trandat09062003/Smart_HVAC_AIOT/comparison_chart.png

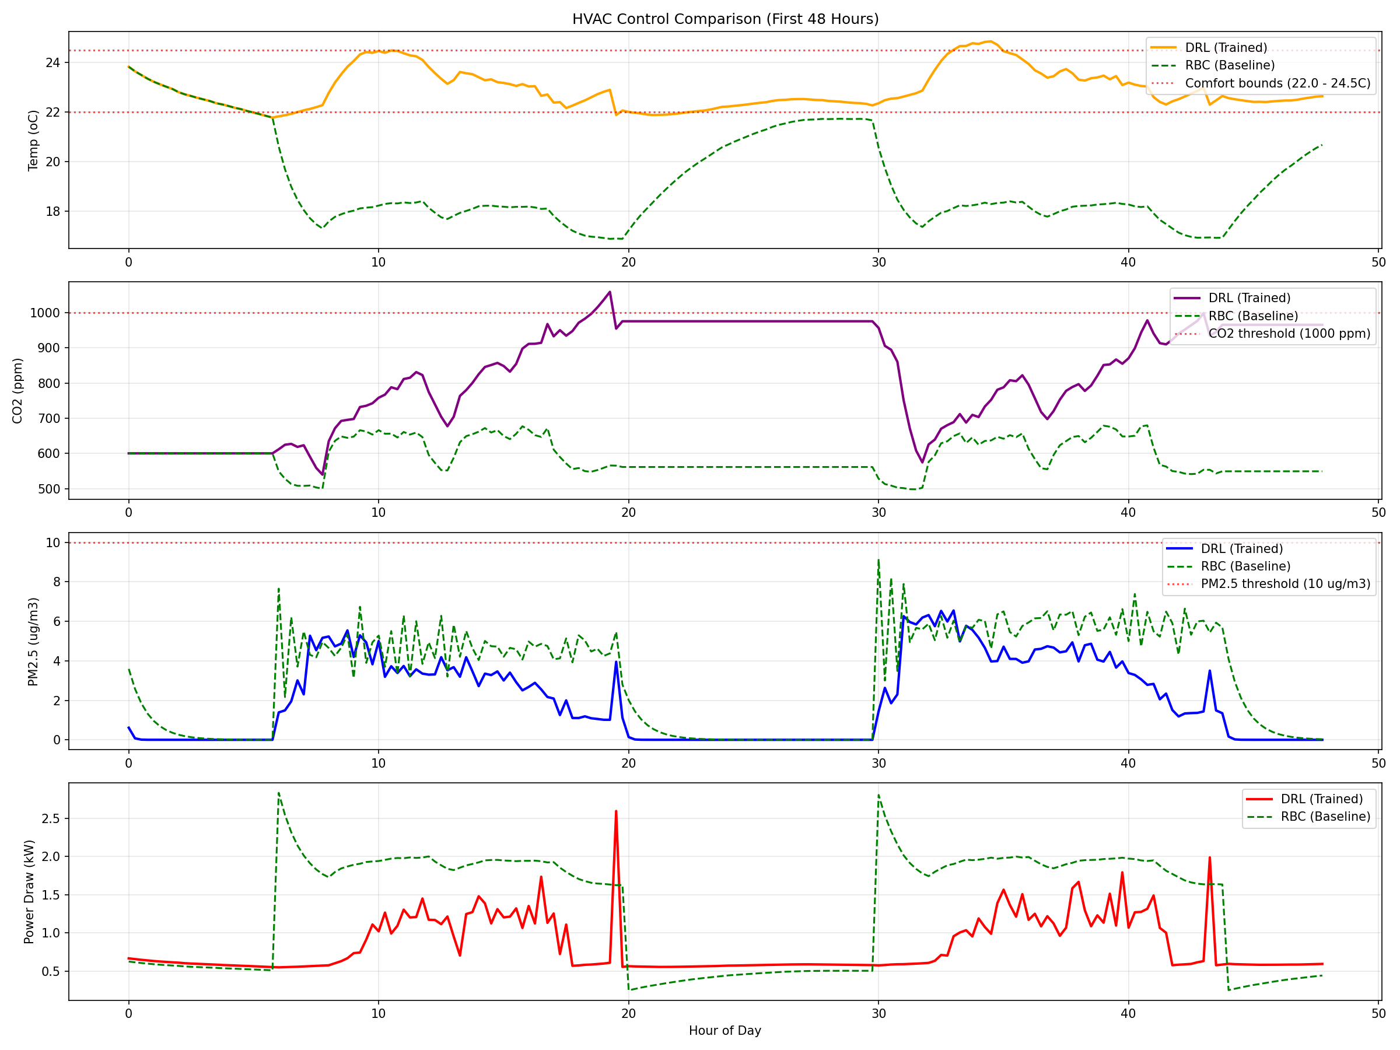
comparison_chart.png
