trandat09062003/Smart_HVAC_AIOT/models/temperature_model/hvac_visual_simulation.gif

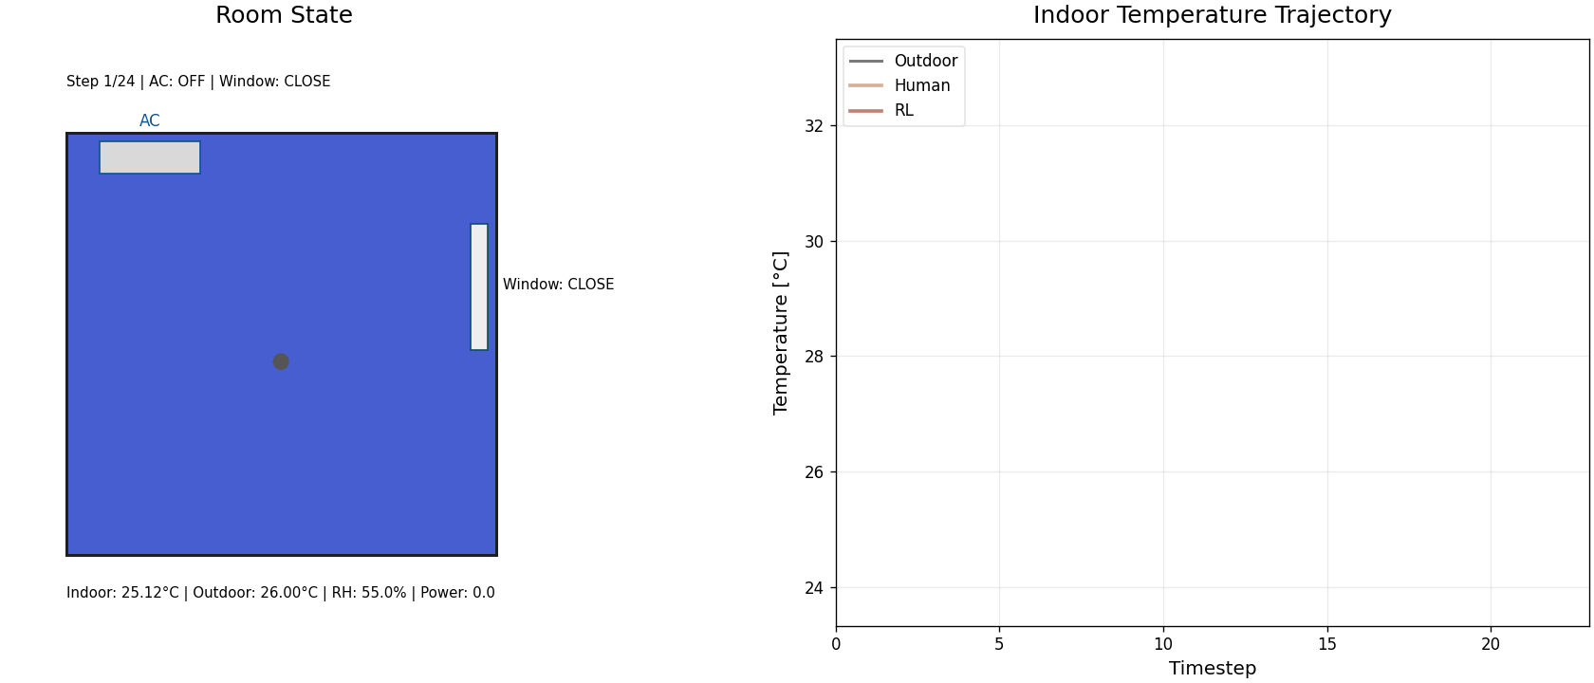
models/temperature_model/hvac_visual_simulation.gif
