trandat09062003/Smart_HVAC_AIOT/models/temperature_model/hvac_visual_simulation_plot.png

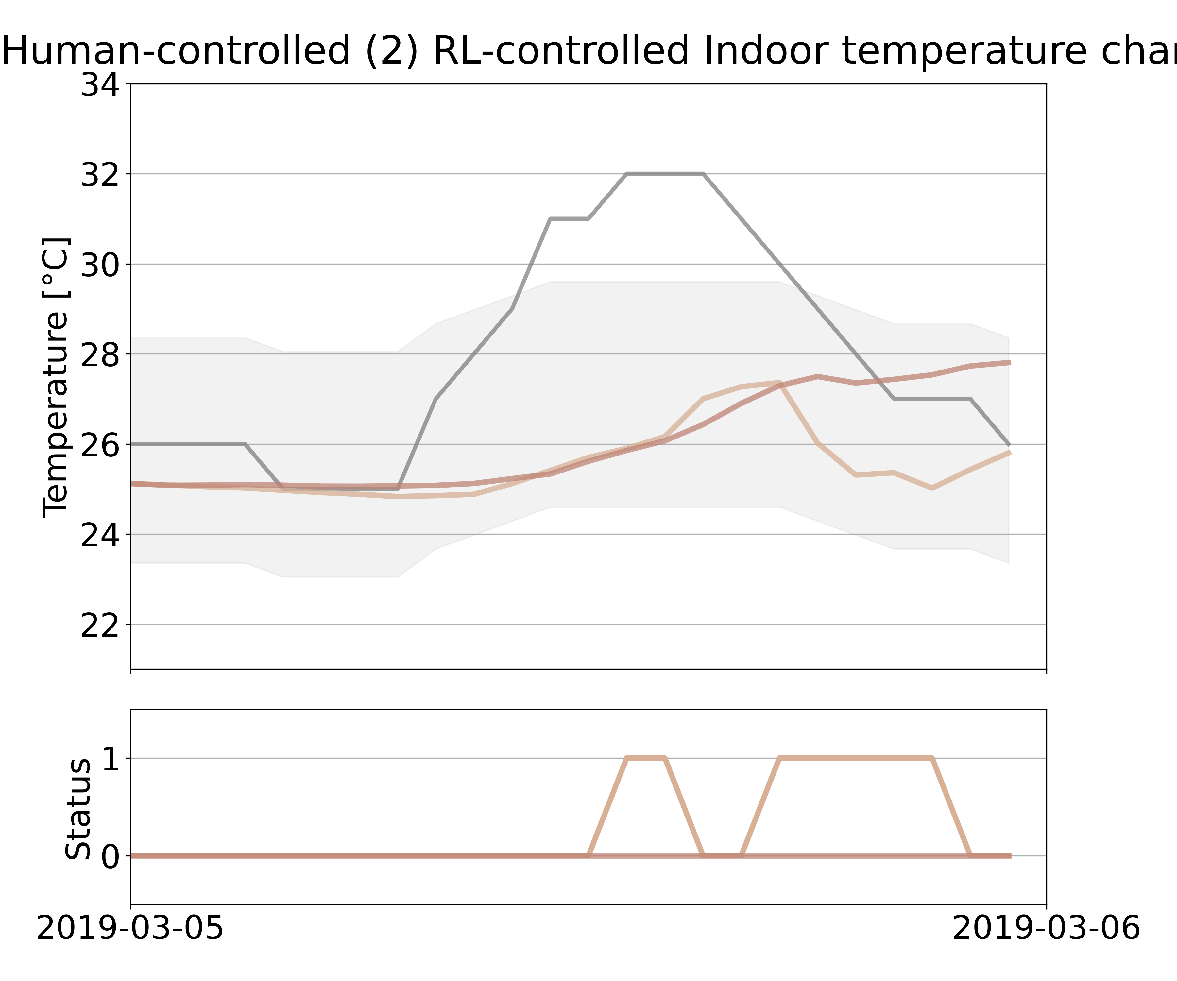
models/temperature_model/hvac_visual_simulation_plot.png
