trandat09062003/Smart_HVAC_AIOT/models/temperature_model/scenario_output_mixed_office_xgbrl.png

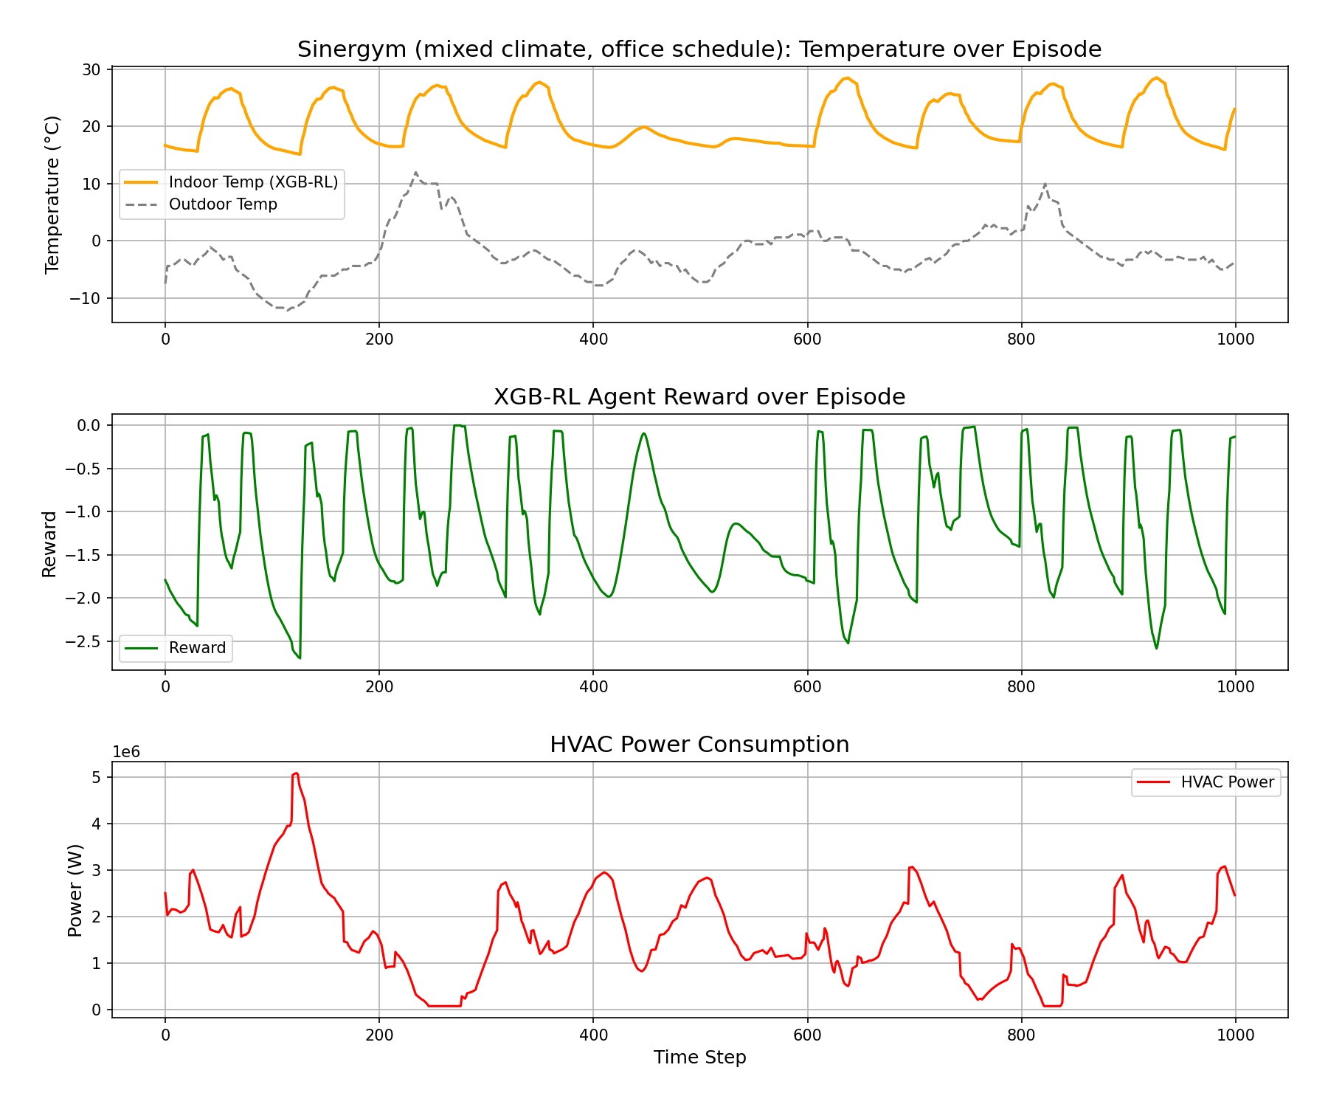
models/temperature_model/scenario_output_mixed_office_xgbrl.png
