trandat09062003/Smart_HVAC_AIOT/models/temperature_model/Eplus-5zone-mixed-continuous-v1-res1/episode-1/output/eplusout.dxf

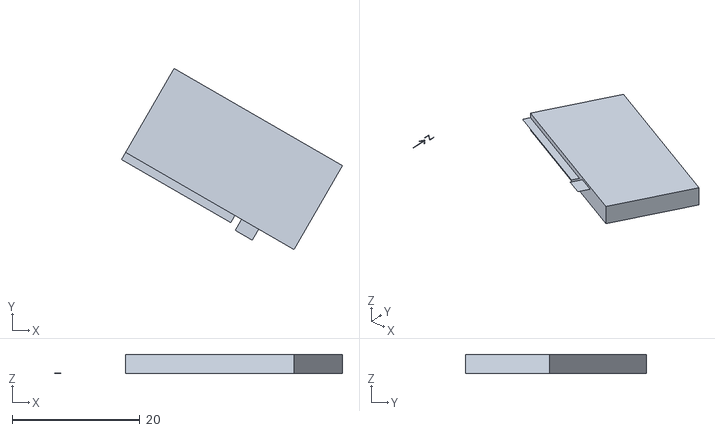
[picture p5: CAD file, 2026-06-03]
models/temperature_model/Eplus-5zone-mixed-continuous-v1-res1/episode-1/output/eplusout.dxf
45.2 x 28.4 x 3.00
