trandat09062003/Smart_HVAC_AIOT/models/temperature_model/performance_comparison.png

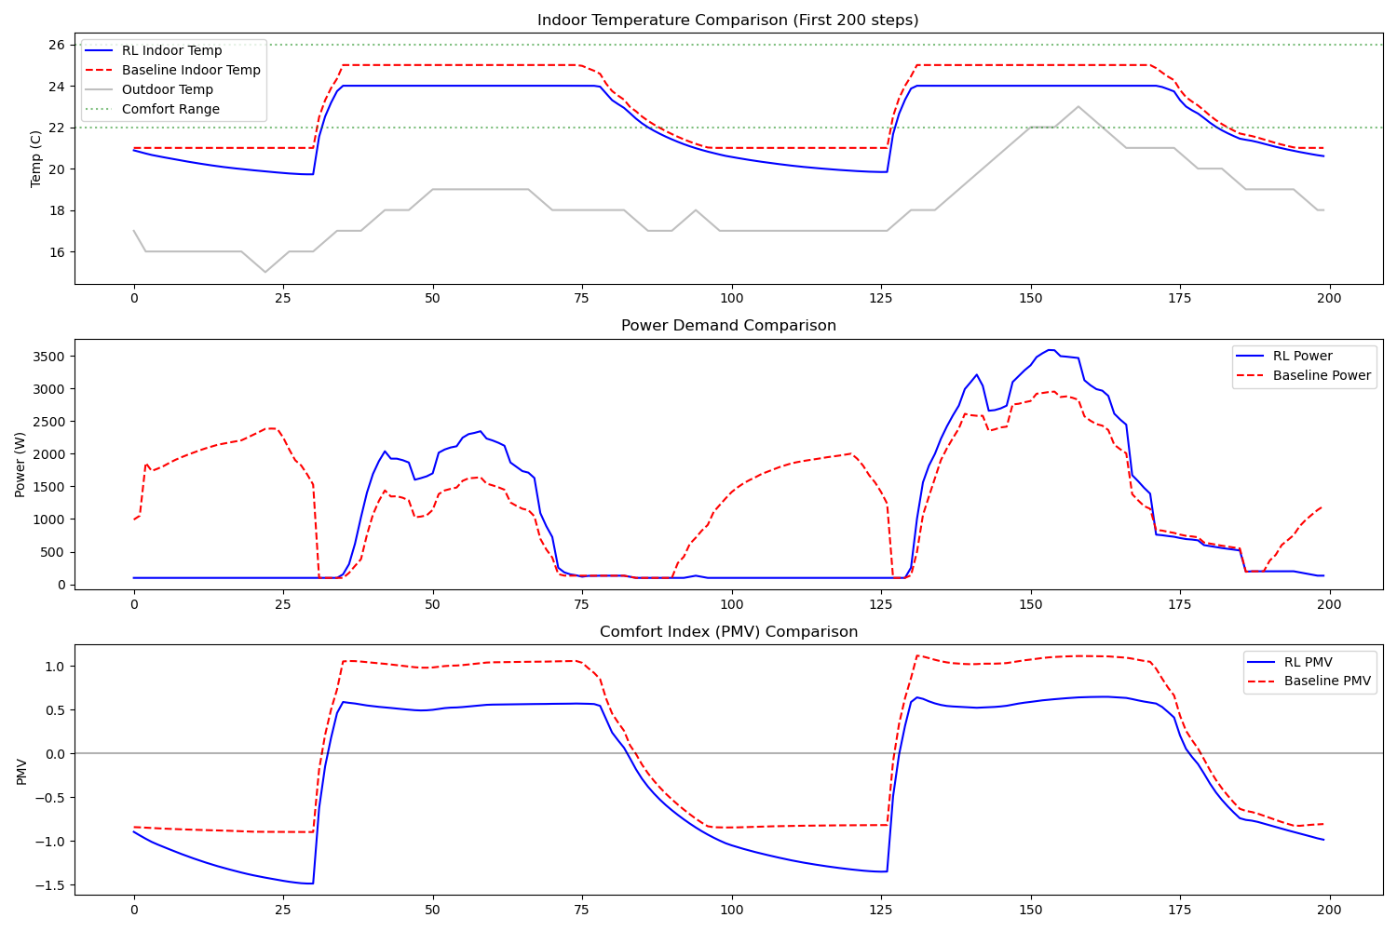
models/temperature_model/performance_comparison.png
