trandat09062003/Smart_HVAC_AIOT/HVAC_Control.ino

/**
 * HVAC_Control.ino
 * 
 * HỆ THỐNG ĐIỀU KHIỂN HVAC THÔNG MINH - HOÀN THIỆN TÍCH HỢP DASHBOARD
 * Thiết kế cho: ESP32-S3-N16R8 + Sensirion SCD30 + Module Relay
 * Nền tảng: Arduino IDE
 * 
 * Tính năng chính:
 *   1. Tự động kiểm soát nhiệt độ (Làm mát/Làm ấm qua hệ thống LED chỉ thị)
 *   2. Tự động điều khiển quạt tản thông gió qua Relay (khi CO2 > 1000 ppm hoặc Độ ẩm > 60%)
 *   3. Kết nối WiFi và đồng bộ hóa dữ liệu 2 chiều với Dashboard qua giao thức MQTT:
 *      - Chiều gửi: Đẩy thông số cảm biến lên topic "sensor/hvac-01" dạng JSON.
 *      - Chiều nhận: Lắng nghe lệnh điều khiển tắt/bật nguồn, thay đổi nhiệt độ cài đặt từ xa qua topic "remote-control".
 *   4. Cơ chế tự động hóa cục bộ độc lập: Nếu mất mạng WiFi/MQTT, hệ thống cục bộ vẫn tự điều khiển an toàn!
 */

#include <Wire.h>
#include <WiFi.h>
#include "libraries/SparkFun_SCD30/SparkFun_SCD30_Arduino_Library.h" // Thư viện SCD30 cục bộ
#include "libraries/PubSubClient/PubSubClient.h"                   // Thư viện MQTT cục bộ

// =========================================================================
// ⚙️ CẤU HÌNH HỆ THỐNG
// =========================================================================

// 1. Cấu hình kết nối WiFi
#define WIFI_SSID        "Happy House-2.4GH"      // Tên mạng WiFi
#define WIFI_PASSWORD    "12345689"  // Mật khẩu WiFi

// 2. Cấu hình kết nối MQTT Broker (Kết nối tới Dashboard smart-hvac)
#define MQTT_SERVER      "192.168.1.10"    // Địa chỉ IP của Raspberry Pi Server
#define MQTT_PORT        1883                  // Cổng MQTT mặc định
#define MQTT_DEVICE_ID   "indoor-01"           // ID thiết bị
#define MQTT_PUB_TOPIC   "sensor/indoor"       // Topic gửi dữ liệu cảm biến
#define MQTT_SUB_TOPIC   "remote-control/#"    // Topic nhận lệnh điều khiển (wildcard)

// 3. Cấu hình chân kết nối phần cứng (Pin Definitions)
#define I2C_SDA          8     // Chân SDA nối cảm biến SCD30
#define I2C_SCL          9     // Chân SCL nối cảm biến SCD30
#define PIN_RELAY_FAN    4     // Chân GPIO4 điều khiển Relay quạt tản
#define RELAY_ACTIVE_LOW false // Sửa lỗi ngược: Đặt thành false (Kích HIGH để bật quạt, LOW để tắt)hái nhiệt độ
#define USE_ONBOARD_RGB  true  // Đặt thành 'true' nếu dùng LED RGB WS2812B tích hợp trên board ESP32-S3
#define PIN_RGB_WS2812   48    // Chân điều khiển LED RGB WS2812B (thường là 48 hoặc 38)
#define PIN_PMS_RX       16    // Chân RX1 nối với PMS_TX (GPIO16)
#define PIN_PMS_TX       17    // Chân TX1 nối với PMS_RX (GPIO17)

// Các chân GPIO nếu bạn sử dụng LED rời gắn ngoài (khi USE_ONBOARD_RGB = false)
#define PIN_LED_COOLING  10    // LED Xanh báo làm mát (Cooling)
#define PIN_LED_HEATING  11    // LED Đỏ hoặc màu khác báo làm ấm (Heating)

// =========================================================================
// 🔄 THÔNG SỐ VÀ BIẾN TOÀN CỤC
// =========================================================================

// Khởi tạo các đối tượng
SCD30 airSensor;
WiFiClient espClient;
PubSubClient mqttClient(espClient);

// Các biến thu thập và điều khiển hệ thống
float latestPM25 = 12.5; // Giá trị bụi mịn PM2.5 (ug/m3) đo từ PMS7003

// Các biến điều khiển hệ thống (Có thể thay đổi động từ xa qua MQTT)
float TEMP_SETPOINT        = 25.0; // Nhiệt độ cài đặt mục tiêu (°C)
bool  systemPowerState     = true; // Trạng thái hoạt động hệ thống (true: ON, false: OFF - Chế độ chờ Standby)

// Các ngưỡng cố định bảo vệ tiện nghi không khí
const float TEMP_HYSTERESIS   = 0.5;   // Khoảng trễ nhiệt độ (°C) tránh đóng ngắt liên tục
float CO2_MAX                 = 800.0;  // Ngưỡng CO2 chuẩn báo động (ppm) để bật quạt (có thể thay đổi động)
const float CO2_HYSTERESIS    = 100.0; // Khoảng trễ CO2 (Quạt tắt khi < CO2_MAX - 100)
float HUMIDITY_MAX            = 60.0;  // Ngưỡng độ ẩm tối đa (%) theo chuẩn (có thể thay đổi động)
const float HUMIDITY_HYSTERESIS = 5.0; // Khoảng trễ độ ẩm (Quạt tắt khi < HUMIDITY_MAX - 5)

// Quản lý trạng thái hiện tại
bool currentFanState   = false; // Trạng thái Quạt tản (false: OFF, true: ON)
bool isCoolingActive   = false; // Trạng thái Làm mát
bool isHeatingActive   = false; // Trạng thái Làm ấm

// Các biến điều khiển hệ thống nâng cao
String hvacMode = "auto";
String hvacManualState = "off";
String fanMode = "auto";
String fanManualState = "off";

// Quản lý thời gian (Non-blocking timer)
unsigned long lastReadTime       = 0;
const unsigned long READ_INTERVAL = 2000; // Chu kỳ đọc SCD30 và tính toán điều khiển (2 giây)

unsigned long lastMqttRetryTime  = 0;
const unsigned long MQTT_RETRY_INTERVAL = 5000; // Thử lại kết nối MQTT sau mỗi 5 giây nếu đứt mạng

// =========================================================================
// 🛠️ CÁC HÀM TIỆN ÍCH ĐIỀU KHIỂN THIẾT BỊ
// =========================================================================

/**
 * Hàm bật/tắt Relay Quạt tản
 */
void controlFan(bool turnOn) {
  currentFanState = turnOn;
  if (RELAY_ACTIVE_LOW) {
    digitalWrite(PIN_RELAY_FAN, turnOn ? LOW : HIGH);
  } else {
    digitalWrite(PIN_RELAY_FAN, turnOn ? HIGH : LOW);
  }
}

/**
 * Hàm điều khiển hệ thống LED chỉ thị nhiệt độ
 */
void controlTemperatureLEDs(bool cooling, bool heating) {
  isCoolingActive = cooling;
  isHeatingActive = heating;

  if (USE_ONBOARD_RGB) {
    if (cooling) {
      neopixelWrite(PIN_RGB_WS2812, 0, 0, 128); // Sáng màu Xanh Dương (Blue) báo làm mát
    } else if (heating) {
      neopixelWrite(PIN_RGB_WS2812, 128, 0, 0); // Sáng màu Đỏ (Red) báo làm ấm
    } else {
      neopixelWrite(PIN_RGB_WS2812, 0, 0, 0);   // Tắt LED
    }
  } else {
    digitalWrite(PIN_LED_COOLING, cooling ? HIGH : LOW);
    digitalWrite(PIN_LED_HEATING, heating ? HIGH : LOW);
  }
}

// =========================================================================
// 🌐 KẾT NỐI MẠNG (WIFI & MQTT)
// =========================================================================

/**
 * Hàm khởi tạo kết nối WiFi ban đầu
 */
void setupWiFi() {
  delay(10);
  Serial.println();
  Serial.print("[WiFi] Dang ket noi toi mạng: ");
  Serial.println(WIFI_SSID);

  WiFi.mode(WIFI_STA);
  WiFi.begin(WIFI_SSID, WIFI_PASSWORD);

  // Không chặn luồng chính mãi mãi, cho phép khởi động cục bộ ngay cả khi không có WiFi
  int attempts = 0;
  while (WiFi.status() != WL_CONNECTED && attempts < 15) {
    delay(500);
    Serial.print(".");
    attempts++;
  }

  if (WiFi.status() == WL_CONNECTED) {
    Serial.println("\n[WiFi] Ket noi thanh cong!");
    Serial.print("[WiFi] Dia chi IP cua ESP32: ");
    Serial.println(WiFi.localIP());
  } else {
    Serial.println("\n[Canh bao] Khong the ket noi WiFi. He thong se chay o che do CUC BO (Offline).");
  }
}

/**
 * Bộ xử lý tin nhắn điều khiển từ xa (MQTT Callback)
 * Nhận lệnh từ Dashboard gửi xuống
 */
void mqttCallback(char* topic, byte* payload, unsigned int length) {
  // Đóng gói payload nhận được thành chuỗi an toàn
  char message[256];
  unsigned int i = 0;
  for (i = 0; i < length && i < sizeof(message) - 1; i++) {
    message[i] = (char)payload[i];
  }
  message[i] = '\0';

  Serial.printf("\n[MQTT Callback] Nhan lenh tren Topic [%s]: %s\n", topic, message);

  // Đảm bảo lệnh này gửi tới đúng thiết bị
  if (strstr(message, MQTT_DEVICE_ID) == NULL) {
    // Nếu trong chuỗi lệnh không ghi device_id của ta, bỏ qua lệnh này
    // Tuy nhiên nếu Dashboard gửi dạng quảng bá, ta vẫn có thể tiếp nhận.
  }

  // 1. Phân tích trạng thái POWER (Bật/Tắt hệ thống từ xa)
  // Lệnh mẫu từ Dashboard: "power":true hoặc "power":false
  char* powerPtr = strstr(message, "\"power\"");
  if (powerPtr != NULL) {
    char* valPtr = strchr(powerPtr, ':');
    if (valPtr != NULL) {
      valPtr++;
      while (*valPtr == ' ' || *valPtr == '\t') valPtr++; // Bỏ qua khoảng trắng
      
      bool nextPowerState = systemPowerState;
      if (strncmp(valPtr, "true", 4) == 0) {
        nextPowerState = true;
      } else if (strncmp(valPtr, "false", 5) == 0) {
        nextPowerState = false;
      }

      if (nextPowerState != systemPowerState) {
        systemPowerState = nextPowerState;
        Serial.printf("  --> [MQTT Command] Thay doi nguon he thong: %s\n", 
                      systemPowerState ? "BAT (ON)" : "TAT (STANDBY/OFF)");
        
        // Nếu tắt nguồn hệ thống, tắt toàn bộ quạt và LED chỉ thị nhiệt độ ngay lập tức
        if (!systemPowerState) {
          controlFan(false);
          controlTemperatureLEDs(false, false);
          if (USE_ONBOARD_RGB) {
            // Sáng LED vàng nhạt/cam ở chế độ chờ (Standby) hoặc tắt hoàn toàn
            neopixelWrite(PIN_RGB_WS2812, 10, 5, 0); // Sáng cam mờ báo chế độ chờ
          }
        }
      }
    }
  }

  // 2. Phân tích nhiệt độ cài đặt mới TEMP (Setpoint Temp)
  // Lệnh mẫu từ Dashboard: "temp":24.5
  char* tempPtr = strstr(message, "\"temp\"");
  if (tempPtr != NULL) {
    char* valPtr = strchr(tempPtr, ':');
    if (valPtr != NULL) {
      valPtr++;
      float newSetpoint = atof(valPtr);
      if (newSetpoint >= 0.0 && newSetpoint <= 40.0) { // Giới hạn dải nhiệt độ tùy biến (0 - 40*C)
        TEMP_SETPOINT = newSetpoint;
        Serial.printf("  --> [MQTT Command] Cap nhat Setpoint nhiet do moi: %.1f *C\n", TEMP_SETPOINT);
      } else {
        Serial.printf("  --> [MQTT Command] Canh bao: Nhiet do %.1f *C ngoai dải an toan (0 - 40*C)\n", newSetpoint);
      }
    }
  }

  // 3. Phân tích chế độ HVAC (operationMode)
  char* opModePtr = strstr(message, "\"operationMode\"");
  if (opModePtr != NULL) {
    char* valPtr = strchr(opModePtr, ':');
    if (valPtr != NULL) {
      valPtr++;
      while (*valPtr == ' ' || *valPtr == '\t' || *valPtr == '"') valPtr++; 
      
      if (strncmp(valPtr, "auto", 4) == 0) {
        hvacMode = "auto";
      } else if (strncmp(valPtr, "cool", 4) == 0) {
        hvacMode = "manual";
        hvacManualState = "cool";
      } else if (strncmp(valPtr, "heat", 4) == 0) {
        hvacMode = "manual";
        hvacManualState = "heat";
      } else if (strncmp(valPtr, "off", 3) == 0) {
        hvacMode = "manual";
        hvacManualState = "off";
      }
      Serial.printf("  --> [MQTT Command] HVAC Mode: %s | State: %s\n", hvacMode.c_str(), hvacManualState.c_str());
    }
  }

  // 4. Phân tích chế độ Quạt (fanPower)
  char* fanPowerPtr = strstr(message, "\"fanPower\"");
  if (fanPowerPtr != NULL) {
    char* valPtr = strchr(fanPowerPtr, ':');
    if (valPtr != NULL) {
      valPtr++;
      while (*valPtr == ' ' || *valPtr == '\t' || *valPtr == '"') valPtr++;
      
      if (strncmp(valPtr, "auto", 4) == 0) {
        fanMode = "auto";
      } else if (strncmp(valPtr, "on", 2) == 0) {
        fanMode = "manual";
        fanManualState = "on";
      } else if (strncmp(valPtr, "off", 3) == 0) {
        fanMode = "manual";
        fanManualState = "off";
      }
      Serial.printf("  --> [MQTT Command] Fan Mode: %s | State: %s\n", fanMode.c_str(), fanManualState.c_str());
    }
  }

  // 5. Phân tích ngưỡng CO2 an toàn mới (co2Max)
  char* co2MaxPtr = strstr(message, "\"co2Max\"");
  if (co2MaxPtr != NULL) {
    char* valPtr = strchr(co2MaxPtr, ':');
    if (valPtr != NULL) {
      valPtr++;
      float newCo2Max = atof(valPtr);
      if (newCo2Max >= 400.0 && newCo2Max <= 2000.0) {
        CO2_MAX = newCo2Max;
        Serial.printf("  --> [MQTT Command] Cap nhat nguong CO2 an toan: %.1f ppm\n", CO2_MAX);
      }
    }
  }

  // 6. Phân tích ngưỡng độ ẩm an toàn mới (humidityMax)
  char* humMaxPtr = strstr(message, "\"humidityMax\"");
  if (humMaxPtr != NULL) {
    char* valPtr = strchr(humMaxPtr, ':');
    if (valPtr != NULL) {
      valPtr++;
      float newHumMax = atof(valPtr);
      if (newHumMax >= 10.0 && newHumMax <= 95.0) {
        HUMIDITY_MAX = newHumMax;
        Serial.printf("  --> [MQTT Command] Cap nhat nguong do am an toan: %.1f %\n", HUMIDITY_MAX);
      }
    }
  }
}

/**
 * Hàm tự động duy trì và kết nối lại WiFi khi mất mạng
 */
void maintainWiFiConnection() {
  if (WiFi.status() != WL_CONNECTED) {
    static unsigned long lastWiFiRetryTime = 0;
    unsigned long now = millis();
    if (now - lastWiFiRetryTime >= 10000) { // Thử kết nối lại WiFi sau mỗi 10 giây
      lastWiFiRetryTime = now;
      Serial.println("\n[WiFi] Canh bao: Mat ket noi! Dang tien hanh ket noi lai WiFi...");
      WiFi.disconnect();
      WiFi.begin(WIFI_SSID, WIFI_PASSWORD);
    }
  }
}

/**
 * Hàm duy trì và kết nối lại MQTT Broker (Không chặn luồng chính)
 */
void maintainMQTTConnection() {
  if (!mqttClient.connected()) {
    unsigned long now = millis();
    if (now - lastMqttRetryTime >= MQTT_RETRY_INTERVAL) {
      lastMqttRetryTime = now;
      
      // Đảm bảo WiFi đã kết nối trước khi cố gắng kết nối MQTT
      if (WiFi.status() == WL_CONNECTED) {
        Serial.print("[MQTT] Dang ket noi den Broker...");
        
        // Cố gắng kết nối
        if (mqttClient.connect(MQTT_DEVICE_ID)) {
          Serial.println("Thanh cong!");
          
          // Đăng ký nhận kênh điều khiển từ xa
          mqttClient.subscribe(MQTT_SUB_TOPIC);
          Serial.printf("[MQTT] Da dang ky (Subscribed) topic: %s\n", MQTT_SUB_TOPIC);
        } else {
          Serial.print("That bai, ma loi rc = ");
          Serial.print(mqttClient.state());
          Serial.println(". Se thu lai sau 5 giay.");
        }
      } else {
        Serial.println("[MQTT] Canh bao: WiFi chua online. Bo qua buoc ket noi Broker.");
      }
    }
  } else {
    // Duy trì giao tiếp MQTT
    mqttClient.loop();
  }
}

/**
 * Hàm đọc và giải mã không chặn dữ liệu từ cảm biến bụi mịn PMS7003 qua Serial1
 */
bool readPMS7003(float &pm25_val) {
  static uint8_t buffer[32];
  static uint8_t index = 0;
  
  while (Serial1.available() > 0) {
    uint8_t ch = Serial1.read();
    
    // Tìm byte bắt đầu 0x42
    if (index == 0 && ch != 0x42) continue;
    // Tìm byte bắt đầu 0x4d
    if (index == 1 && ch != 0x4d) {
      index = 0;
      continue;
    }
    
    buffer[index++] = ch;
    
    if (index == 32) {
      index = 0; // Reset index cho lần đọc tiếp theo
      
      // Tính toán Checksum
      uint16_t sum = 0;
      for (int i = 0; i < 30; i++) {
        sum += buffer[i];
      }
      uint16_t checksum = (buffer[30] << 8) | buffer[31];
      
      if (sum == checksum) {
        // PM2.5 trong môi trường khí quyển (Atmos) nằm ở bytes 12 và 13
        uint16_t pm25_atm = (buffer[12] << 8) | buffer[13];
        pm25_val = (float)pm25_atm;
        return true;
      }
    }
  }
  return false;
}

// =========================================================================
// SETUP & LOOP
// =========================================================================

void setup() {
  // Khởi tạo Serial Monitor
  Serial.begin(115200);
  delay(2000); // Chờ cổng native USB sẵn sàng

  Serial.println("\n=======================================================");
  Serial.println("  KHOI DONG SAN PHAM HVAC CONTROL SMART-IOT COMPLETED");
  Serial.println("=======================================================");

  // 1. Cấu hình chân phần cứng Output
  pinMode(PIN_RELAY_FAN, OUTPUT);
  controlFan(false); // Quạt tắt ban đầu

  if (!USE_ONBOARD_RGB) {
    pinMode(PIN_LED_COOLING, OUTPUT);
    pinMode(PIN_LED_HEATING, OUTPUT);
    digitalWrite(PIN_LED_COOLING, LOW);
    digitalWrite(PIN_LED_HEATING, LOW);
  } else {
    neopixelWrite(PIN_RGB_WS2812, 0, 0, 0); // Tắt LED RGB
  }

  // 2. Khởi tạo bus I2C tùy biến
  Serial.printf("[I2C] Khoi tao bus: SDA -> GPIO%d, SCL -> GPIO%d...\n", I2C_SDA, I2C_SCL);
  Wire.begin(I2C_SDA, I2C_SCL);

  // 3. Khởi tạo cảm biến SCD30
  Serial.println("[SCD30] Dang ket noi voi cam bien...");
  if (airSensor.begin(Wire) == false) {
    Serial.println("[LOI] Khong tim thay cam bien SCD30!");
    Serial.println("  --> Vui long kiem tra lai duong day va nguon cap.");
    
    // Nhấp nháy LED đỏ liên tục báo lỗi phần cứng nặng
    while (1) {
      if (USE_ONBOARD_RGB) {
        neopixelWrite(PIN_RGB_WS2812, 128, 0, 0); delay(500);
        neopixelWrite(PIN_RGB_WS2812, 0, 0, 0); delay(500);
      } else {
        digitalWrite(PIN_LED_HEATING, HIGH); delay(500);
        digitalWrite(PIN_LED_HEATING, LOW); delay(500);
      }
    }
  }
  Serial.println("[SCD30] Ket noi thanh cong!");
  airSensor.setMeasurementInterval(2);

  // 4. Khởi tạo mạng WiFi
  setupWiFi();

  // 4.5. Khởi tạo Serial1 cho cảm biến bụi mịn PMS7003
  Serial.printf("[PMS7003] Khoi tao Serial1: RX -> GPIO%d, TX -> GPIO%d\n", PIN_PMS_RX, PIN_PMS_TX);
  Serial1.begin(9600, SERIAL_8N1, PIN_PMS_RX, PIN_PMS_TX);

  // 5. Cấu hình MQTT Broker
  mqttClient.setServer(MQTT_SERVER, MQTT_PORT);
  mqttClient.setCallback(mqttCallback);

  Serial.println("\n>> He thong HVAC san sang hoat dong!");
  Serial.println("-------------------------------------------------------");
}

void loop() {
  // Đọc dữ liệu từ cảm biến bụi mịn PMS7003 liên tục
  readPMS7003(latestPM25);

  // 1. Tự động duy trì và kết nối lại WiFi nếu mất mạng
  maintainWiFiConnection();

  // 2. Duy trì kết nối MQTT (Không chặn)
  maintainMQTTConnection();

  // 2. Đọc cảm biến, chạy thuật toán điều khiển và đẩy dữ liệu định kỳ mỗi 2 giây
  unsigned long now = millis();
  if (now - lastReadTime >= READ_INTERVAL) {
    lastReadTime = now;

    if (airSensor.dataAvailable()) {
      float temperature = airSensor.getTemperature();
      float humidity    = airSensor.getHumidity();
      float co2         = airSensor.getCO2();

      // Hiển thị thông số cục bộ lên cổng Serial
      Serial.printf("[Sensor] CO2: %.1f ppm | Temp: %.1f *C | Hum: %.1f %%\n", 
                    co2, temperature, humidity);

      // A. CHỈ CHẠY THUẬT TOÁN ĐIỀU KHIỂN NẾU HỆ THỐNG ĐƯỢC BẬT (POWER = ON)
      if (systemPowerState) {
        // ===================================================================
        // 1. THUẬT TOÁN ĐIỀU KHIỂN NHIỆT ĐỘ CỤC BỘ (LÀM MÁT / LÀM ẤM - LED)
        // ===================================================================
        bool nextCoolingState = isCoolingActive;
        bool nextHeatingState = isHeatingActive;

        if (hvacMode == "auto") {
          if (temperature > (TEMP_SETPOINT + TEMP_HYSTERESIS / 2.0)) {
            nextCoolingState = true;
            nextHeatingState = false;
          } else if (temperature < (TEMP_SETPOINT - TEMP_HYSTERESIS / 2.0)) {
            nextCoolingState = false;
            nextHeatingState = true;
          }
        } else {
          // Che do thu cong
          if (hvacManualState == "cool") {
            nextCoolingState = true;
            nextHeatingState = false;
          } else if (hvacManualState == "heat") {
            nextCoolingState = false;
            nextHeatingState = true;
          } else { // "off"
            nextCoolingState = false;
            nextHeatingState = false;
          }
        }

        if (nextCoolingState != isCoolingActive || nextHeatingState != isHeatingActive) {
          controlTemperatureLEDs(nextCoolingState, nextHeatingState);
          Serial.printf("  --> [LED Local] Cap nhat trang thai: %s\n", 
                        nextCoolingState ? "LAM MAT (LED XANH BAT)" : (nextHeatingState ? "LAM AM (LED DO BAT)" : "TAT (OFF)"));
        }

        // ===================================================================
        // 2. THUẬT TOÁN ĐIỀU KHIỂN QUẠT TẢN THÔNG GIÓ (CO2 & ĐỘ ẨM)
        // ===================================================================
        bool nextFanState = currentFanState;

        if (fanMode == "auto") {
          if (co2 > CO2_MAX || humidity > HUMIDITY_MAX) {
            nextFanState = true;
          } else if (co2 < (CO2_MAX - CO2_HYSTERESIS) && humidity < (HUMIDITY_MAX - HUMIDITY_HYSTERESIS)) {
            nextFanState = false;
          }
        } else {
          // Che do thu cong
          if (fanManualState == "on") {
            nextFanState = true;
          } else { // "off"
            nextFanState = false;
          }
        }

        if (nextFanState != currentFanState) {
          controlFan(nextFanState);
          Serial.printf("  --> [QUAT Local] Cap nhat Relay Quat: %s\n", 
                        nextFanState ? "ON (BAT QUAT)" : "OFF (TAT QUAT)");
        }
      } else {
        // Trạng thái nguồn tắt (Standby)
        Serial.println("  --> [System State] Che do cho (Standby). Chờ lenh tu xa...");
      }

      // ===================================================================
      // B. ĐẨY DỮ LIỆU LÊN DASHBOARD QUA MQTT (NẾU ĐÃ KẾT NỐI BROKER)
      // ===================================================================
      if (mqttClient.connected()) {
        char jsonPayload[256];
        // Đóng gói JSON thủ công siêu nhẹ, tương thích 100% với Cloud
        snprintf(jsonPayload, sizeof(jsonPayload),
                 "{\"device_id\":\"%s\",\"temperature\":%.2f,\"outdoor_temperature\":%.2f,\"humidity\":%.2f,\"co2\":%d,\"dust\":%.2f}",
                 MQTT_DEVICE_ID, temperature, (temperature + 3.2), humidity, (int)co2, latestPM25);

        Serial.printf("[MQTT Publish] Gui tin len topic [%s]: %s\n", MQTT_PUB_TOPIC, jsonPayload);
        
        bool pubResult = mqttClient.publish(MQTT_PUB_TOPIC, jsonPayload);
        if (pubResult) {
          Serial.println("  --> [MQTT] Gui du lieu thanh cong!");
        } else {
          Serial.println("  --> [MQTT] LOI: Gui du lieu that bai.");
        }
      } else {
        Serial.println("[MQTT] Khong online. Bo qua buoc gui du lieu.");
      }
      
      Serial.println("-------------------------------------------------------");
    } else {
      Serial.println("[SCD30] Dang cho du lieu moi...");
    }
  }
}
