trandat09062003/Smart_HVAC_AIOT/(commit log)

2026-05-24 config: update MQTT broker IP to Pi's new IP (192.168.1.17)
    [HVAC_Control.ino]
2026-05-24 feat: complete dynamic AI thresholds, real-time energy simulation, baseline comparison analytics, and premium UI redesign
    [HVAC_Control.ino]
2026-05-24 chart: convert real-time graph to plot cumulative energy consumption in kWh instead of power in Watts
2026-05-24 refactor: relocate Arduino C++ libraries from React src/ to root libraries/ directory
2026-06-03 Feat: Add DRL HVAC controller replication, evaluation script, and benchmarking against RBC/Random baselines
    [Sinergym_Transition_Data.csv, eplusout.dxf, uci_occupancy.csv]
2026-06-04 update pin connection for pms7003 to match pcb layout
